michalshani1/fish-led-controller/final/docs/Poster - Real-Time Visual Stimulation System for Studying Escape Behavior in Electric Fish.png

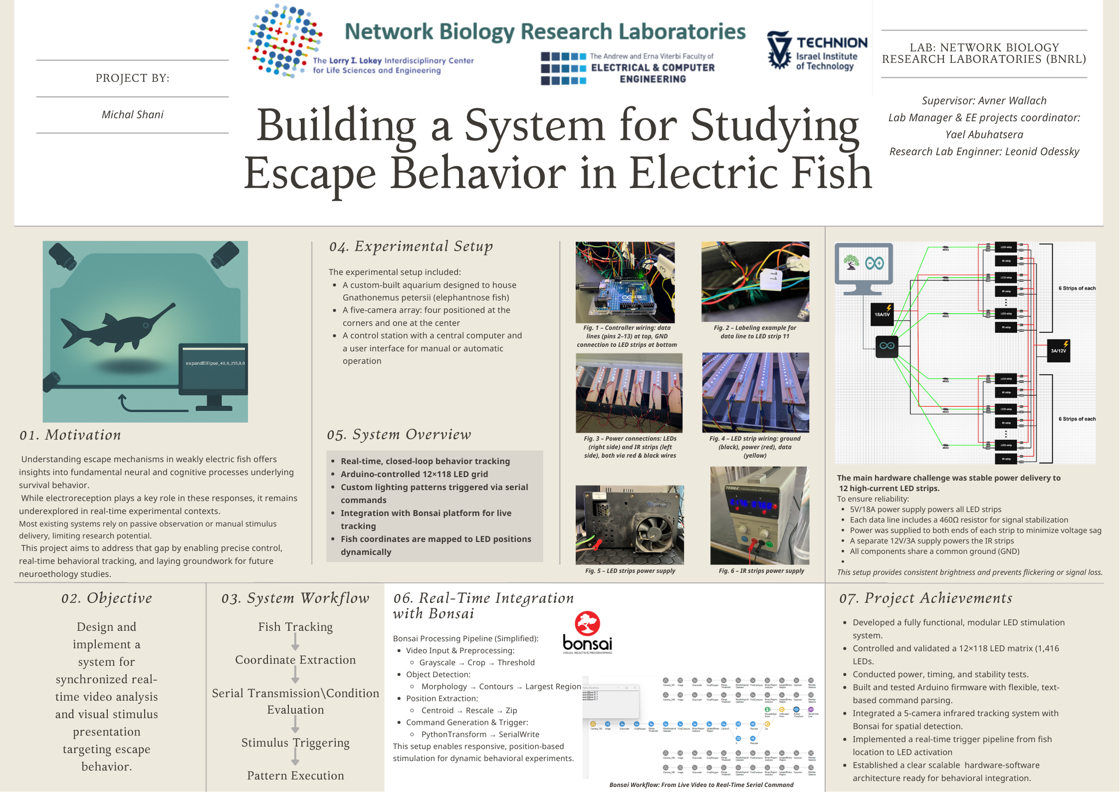
final/docs/Poster - Real-Time Visual Stimulation System for Studying Escape Behavior in Electric Fish.png
