michalshani1/fish-led-controller/final/pictures/IR_strip.jpg

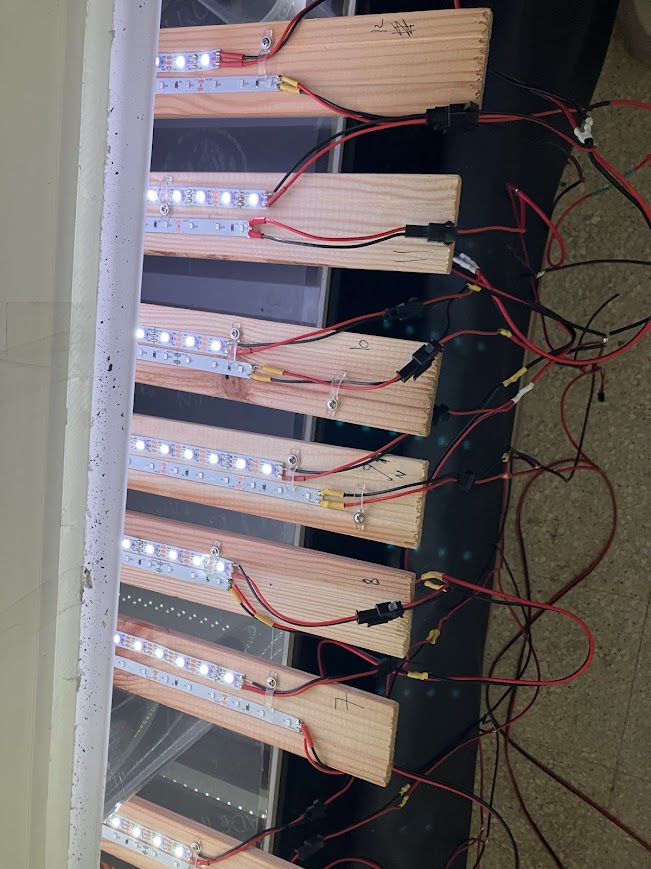
final/pictures/IR_strip.jpg
