michalshani1/fish-led-controller/final/pictures/arduino.jpg

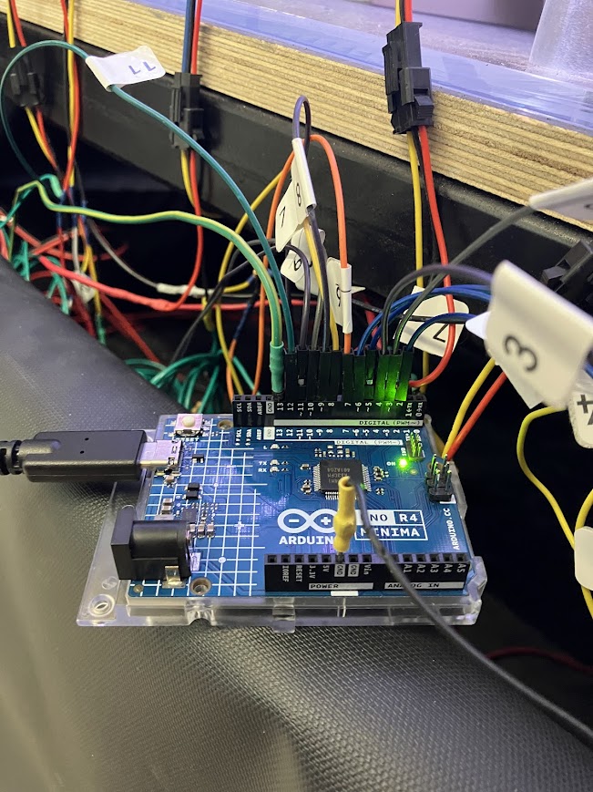
final/pictures/arduino.jpg
