michalshani1/fish-led-controller/final/pictures/IR_power_supply.jpg

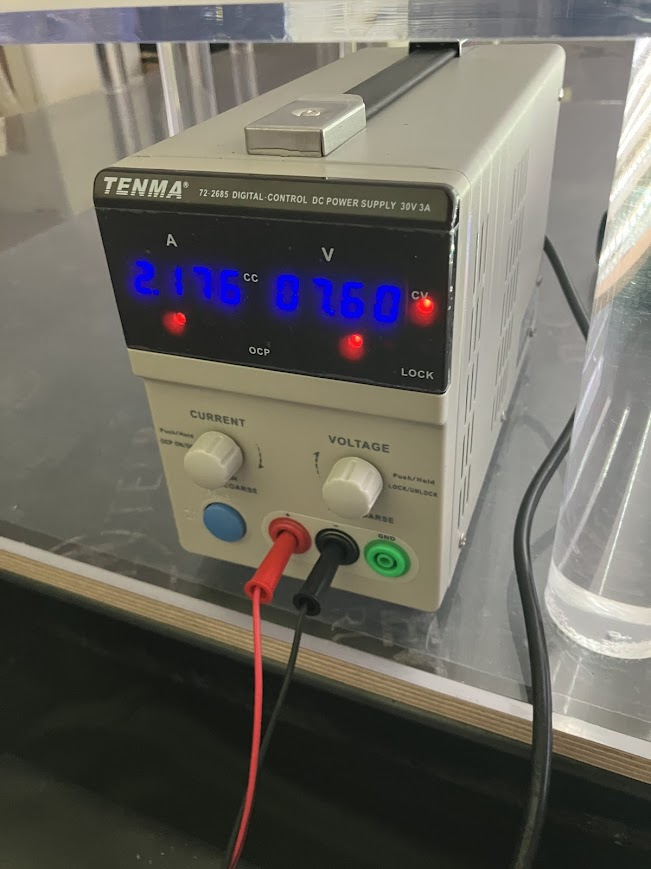
final/pictures/IR_power_supply.jpg
