michalshani1/fish-led-controller/final/pictures/LED_power_supply.jpg

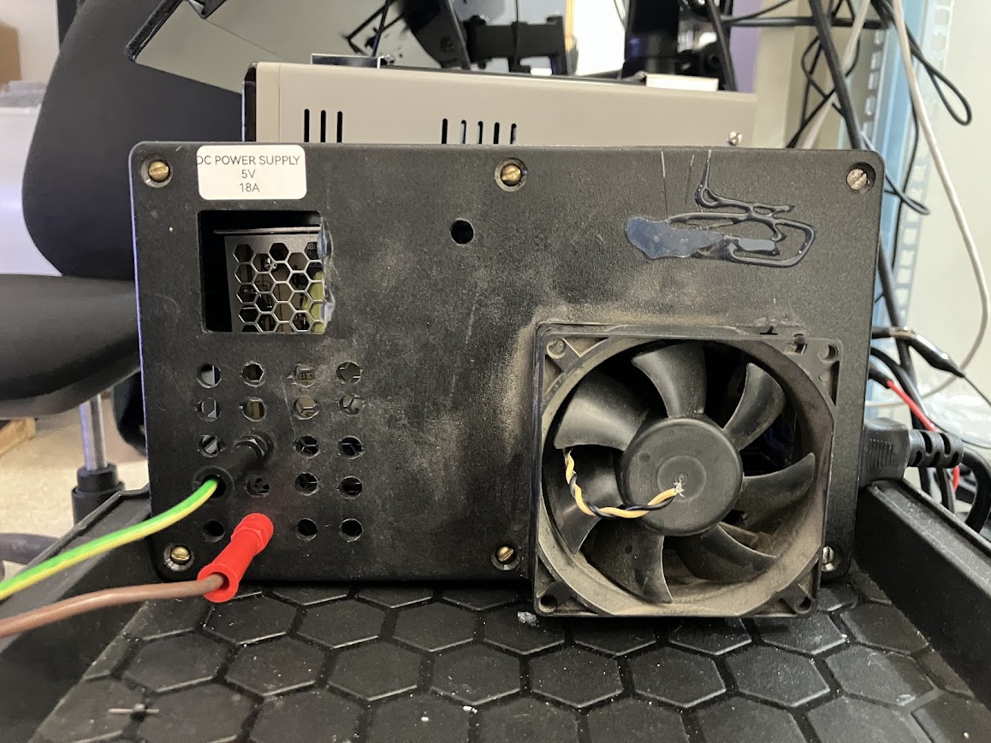
final/pictures/LED_power_supply.jpg
