michalshani1/fish-led-controller/final/pictures/led_strip.jpg

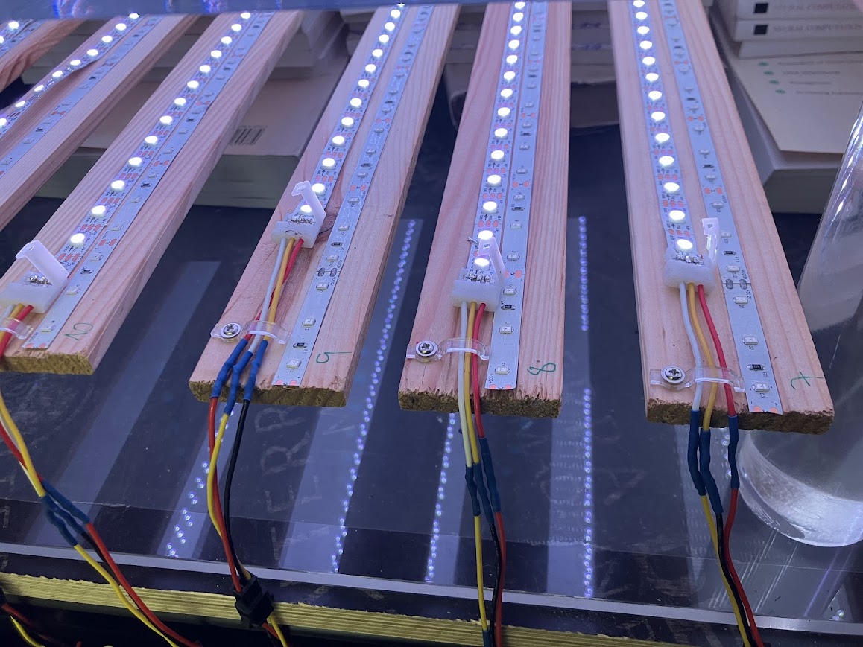
final/pictures/led_strip.jpg
