michalshani1/fish-led-controller/final/pictures/wire_number_tag.jpg

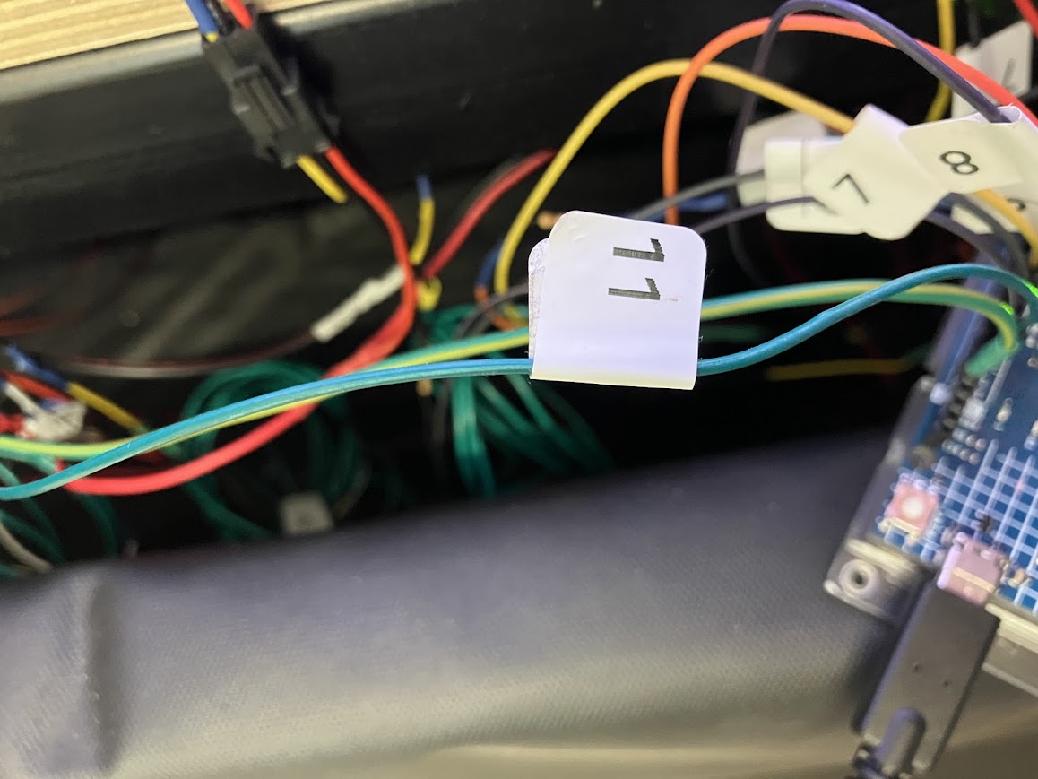
final/pictures/wire_number_tag.jpg
