michalshani1/fish-led-controller/(commit log)

2025-04-15 Add files via upload
    Ass full code for Arduino LED control system
2025-05-04 Update led_serial_controller.ino
    update with serial command
2025-05-12 Create folder for the arduino code
2025-05-12 Create .folder for the arduino code
2025-05-12 Create led_controller.cpp
    final version of the arduino cpp code
2025-05-12 Create led_controller.h
    final version of the .h code for arduino
2025-05-12 Update led_controller.cpp
    adding reset to sunlight color after visual effects
    [led_controller.cpp]
2025-05-12 Update led_controller.h
    adding reset after visual effects
    [led_controller.h]
2025-05-12 Create led_serial_controller.ino
    final version of the main ino code for arduino
2025-05-12 Add files via upload
    sketch of the LED system
2025-05-12 Update and rename led_controller.cpp to controller_drafts/led_controller.cpp
2025-05-12 Update and rename led_controller.h to controller_drafts/led_controller.h
2025-05-12 Rename led_serial_controller.ino to controller_drafts/led_serial_controller.ino
